YentenTros/LINEFOLLOWER/gebruiksaanwijzing/readme.md

### settings
De robot rijdt stabiel met volgende parameters:  
power:  76  
diff: 0.46  
kp: 17.70
