YentenTros/LINEFOLLOWER/bill of materials/BOM.pdf

nr | Naam | omschrijving | Prijs/Stuk Aantal | Subtotaal
1 Microcontroller | ATmega328 (Arduino Nano) | 23 | 1 | 23
2 Sensoren | QTR-8A/8x-ir-lijn-tracking-module | 4,5 | 1 | 4,5
3 H-bruggen | TB6612FNG Motordriver | 7 | 1 | 7
4 Bluetooth module HC-05 | 10,5 | 1 | 10,5
5 Motoren | JGA12-N20-50 | 4,5 | 2 | 9
6 Led | Led Groen 5V | 0 | 1 | 0
7 Drukknop | Drukknop | 0 | 1 | 0
8 Schakelaar | Mini wipschakelaar | 0,5 | 1 | 0,5
9 Weerstand | Weerstand 220Ω | 0 | 1 | 0
10 Batterij | lithium ions | 5,75 | 2 | 11,5
11 Batterij houder | 2 | 1 | 2
12 Wiel | DC Gearbox wiel 65mm | 2,2 | 2 | 4,4
13 printplaatje | dubbelzijdige 4cm*6cm printplaat | 0,7 | 1 | 0,7
73,1

Model A
