YentenTros/LINEFOLLOWER/technische tekeningen/elektronisch/Aansluitschema+poc's.pdf

9000

F26_001

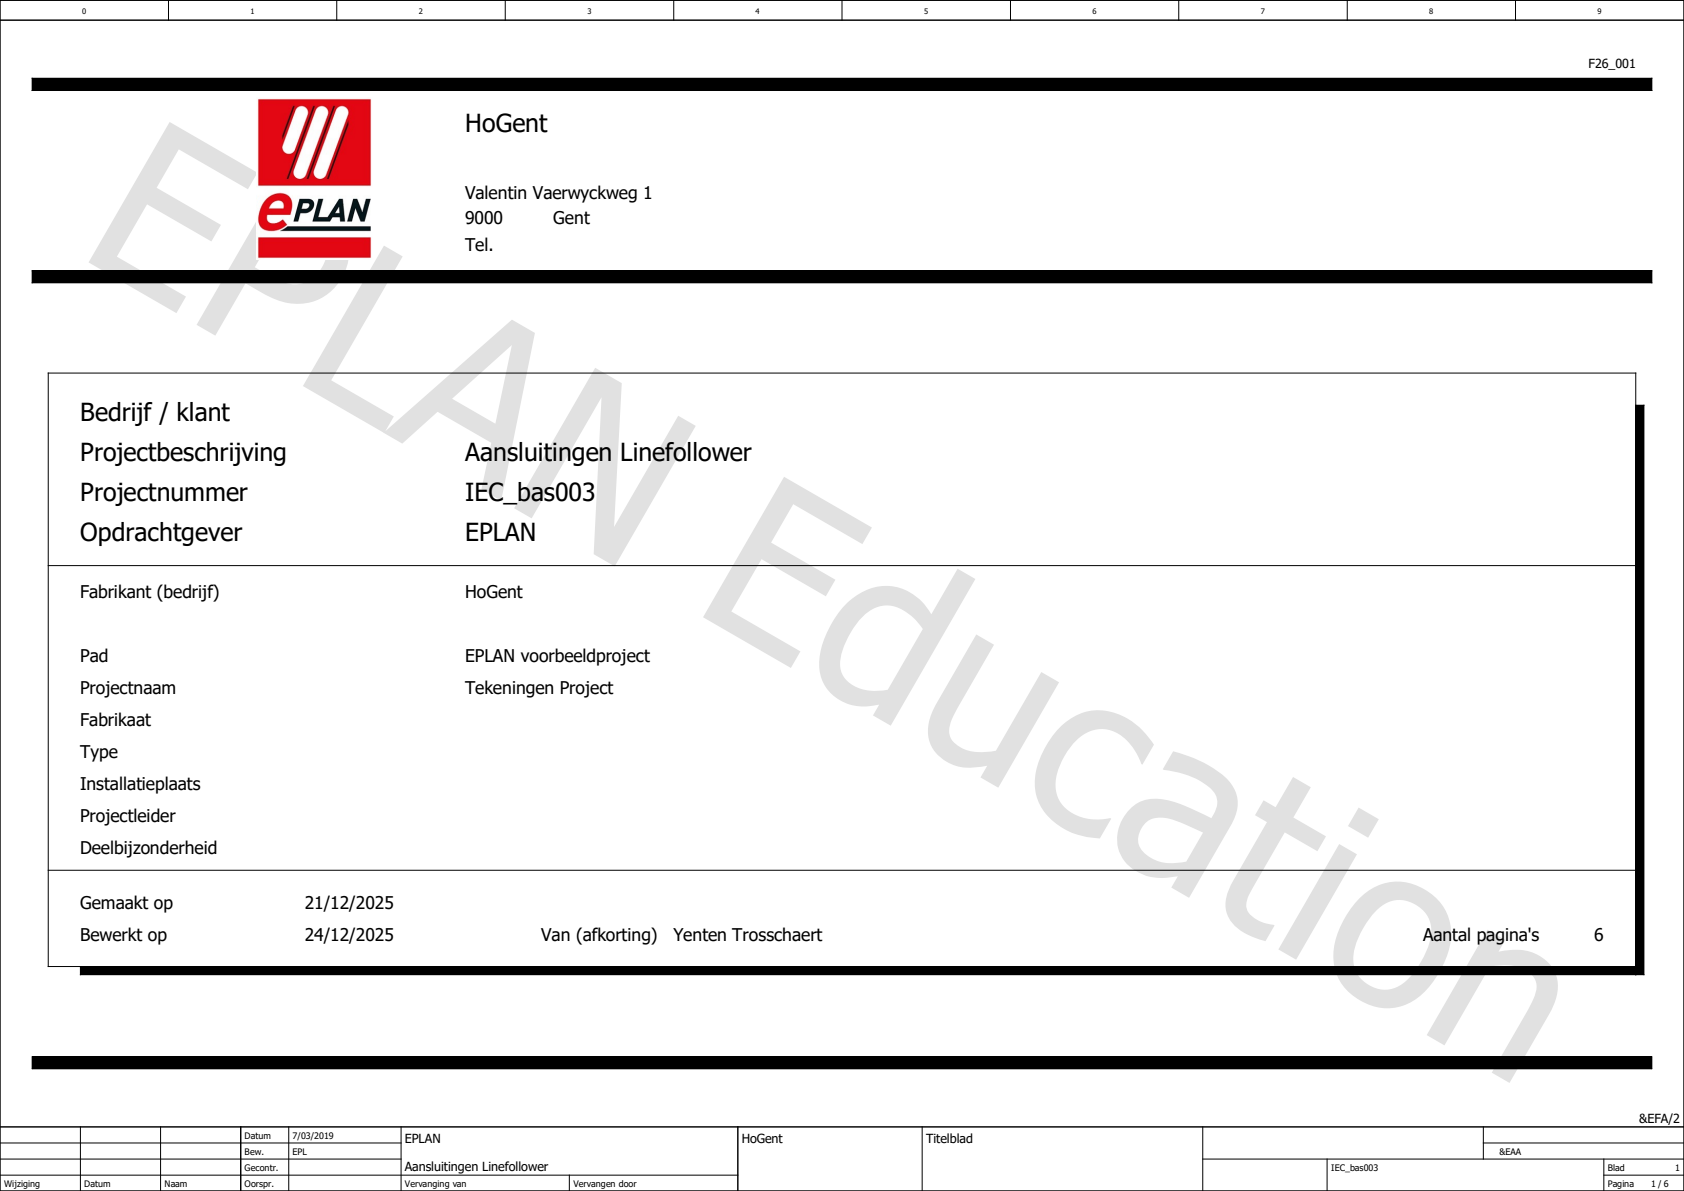
[picture p7: page 1]
&EFA/2; HoGent; Projectbeschrijving; Aansluitingen Linefollower; Aantal pagina's; Opdrachtgever; Bewerkt op; IEC_bas003; Gemaakt op; Projectnummer; EPLAN voorbeeldproject; Fabrikaat; Yenten Trosschaert; Deelbijzonderheid; Valentin Vaerwyckweg 1; Pad; Fabrikant (bedrijf); Projectnaam; Tekeningen Project; Projectleider; Tel.; Type; Bedrijf / klant; Installatieplaats; Van (afkorting); EPLAN; Gent

7/03/2019 | EPLAN Aansluitingen Linefollower | HoGent | Titelblad

Bew. | EPL | | | | &EAA
Gecontr. | | | | | IEC_bas003 | Blad

Wijziging | Datum | Naam | Oorspr. | | Vervanging van | Vervangen door | | | | Pagina 1 / 6

HC-05

## 2 Li-ion Batterijen

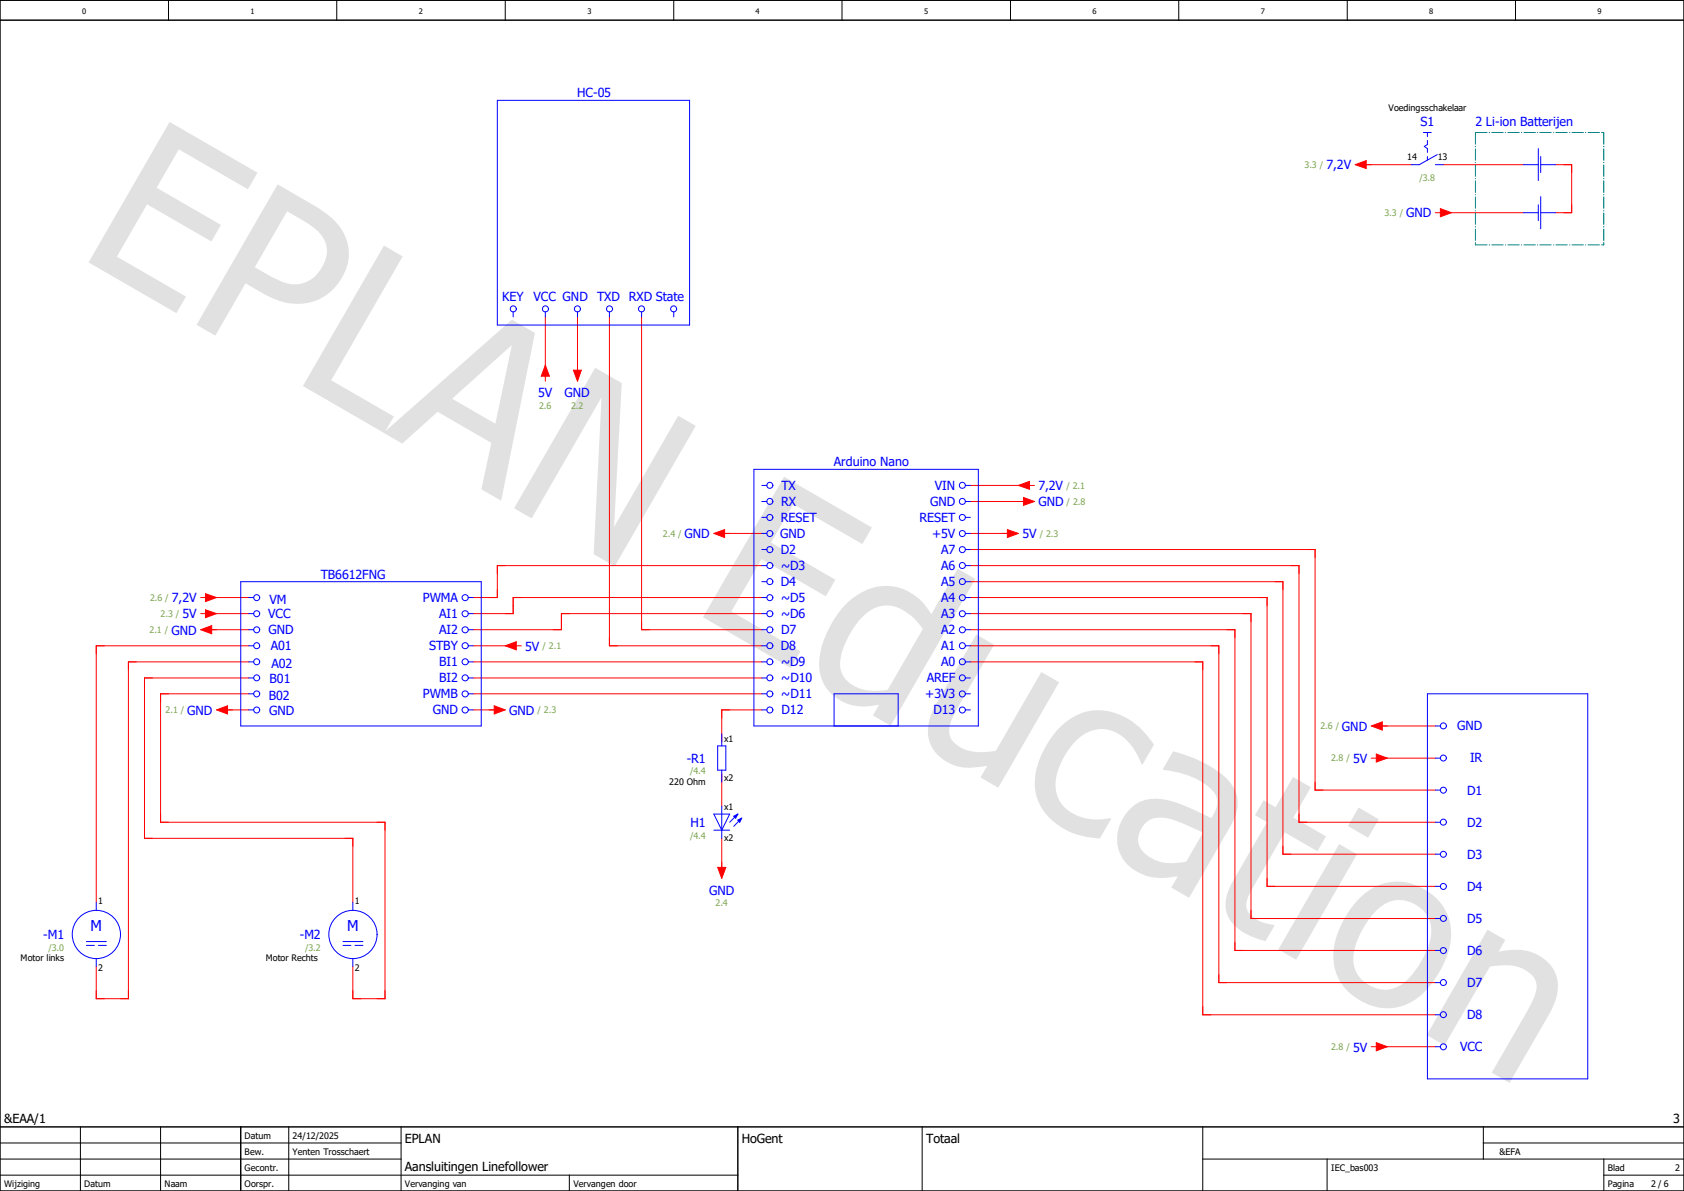
[picture p8: page 2]

KEY VCC GND TXD RXD State

24/12/2025 | HoGent | Totaal
Yenten Trosschaert | | | &EFA

## 2 Li-ion Batterijen

S1

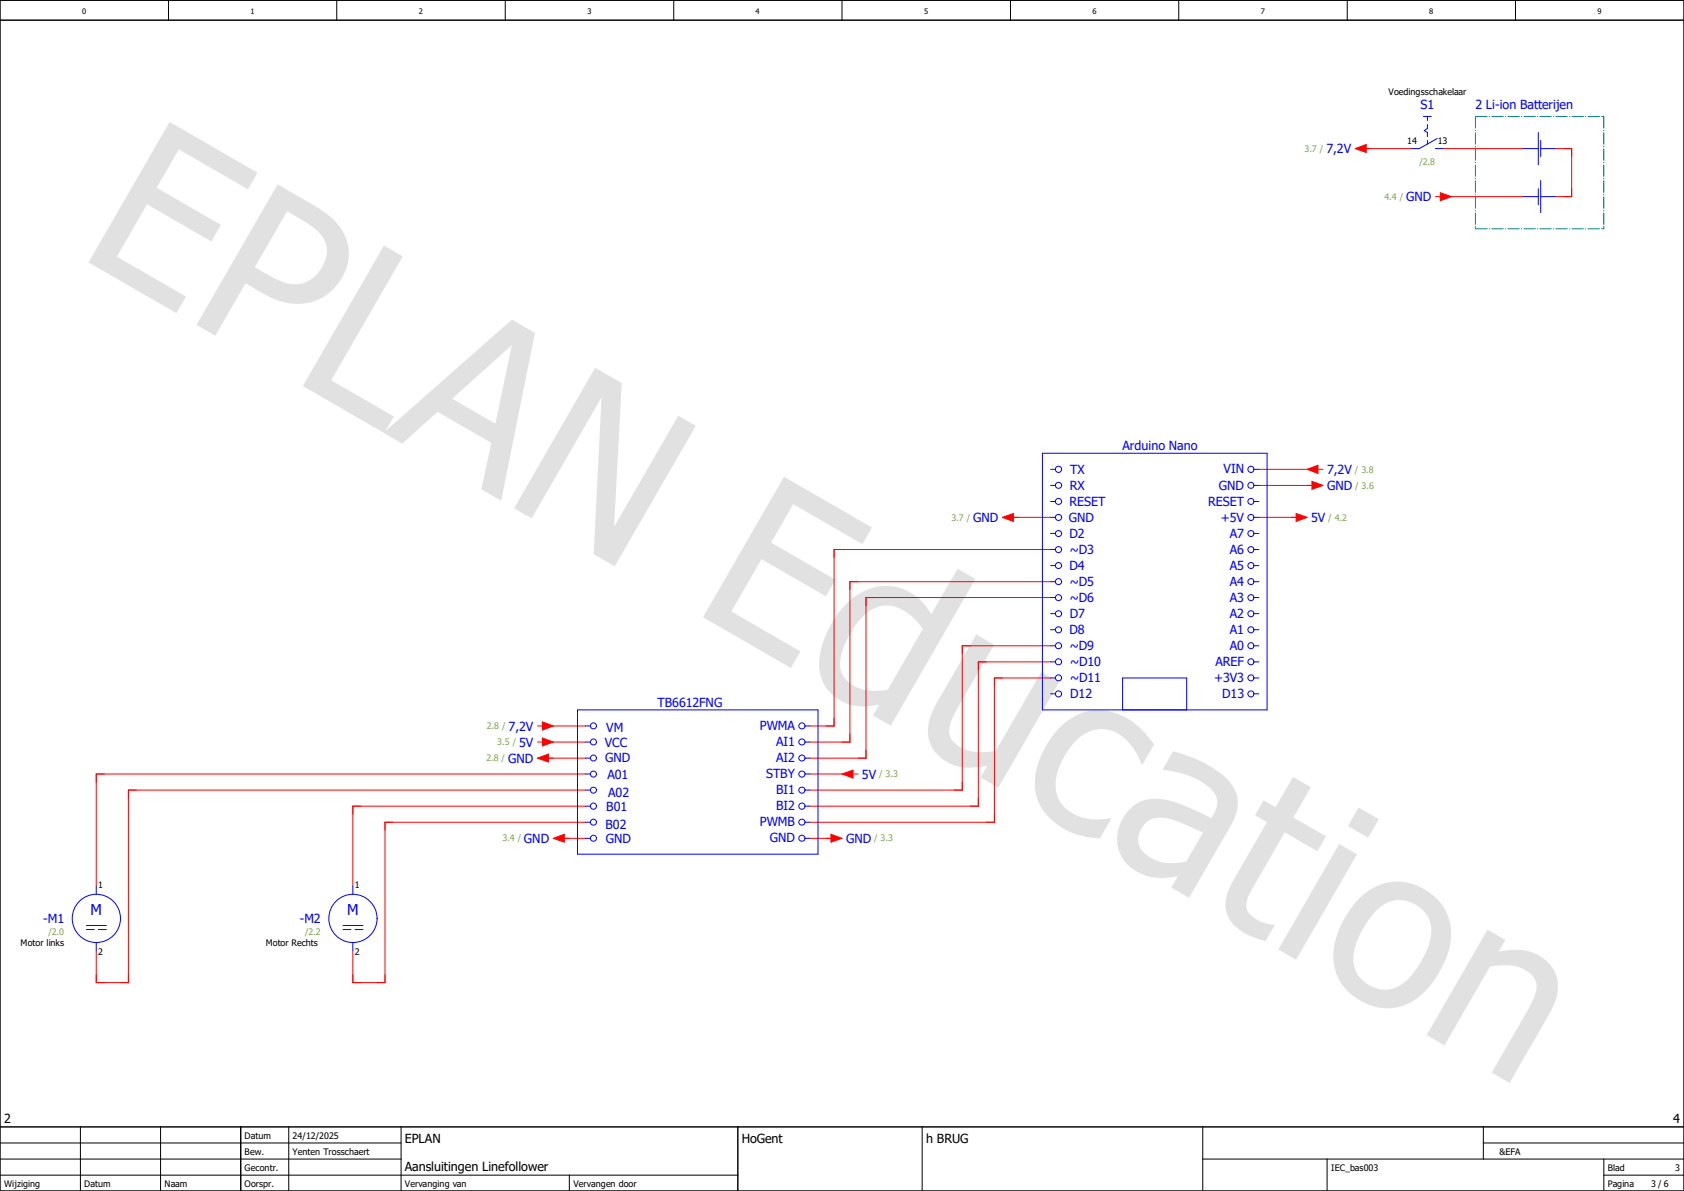
[picture p9: page 3]
h BRUG; Arduino Nano; TB6612FNG; TX RX RESET; AREF; RESET; VIN; GND; Voedingsschakelaar; PWMB; STBY; PWMA; VCC GND A01 A02 B01 B02 GND; Motor links; Motor Rechts; 4.4 / GND; GND / 3.6; 3.7 / GND; 3.4 / GND; 2.8 / GND; GND / 3.3

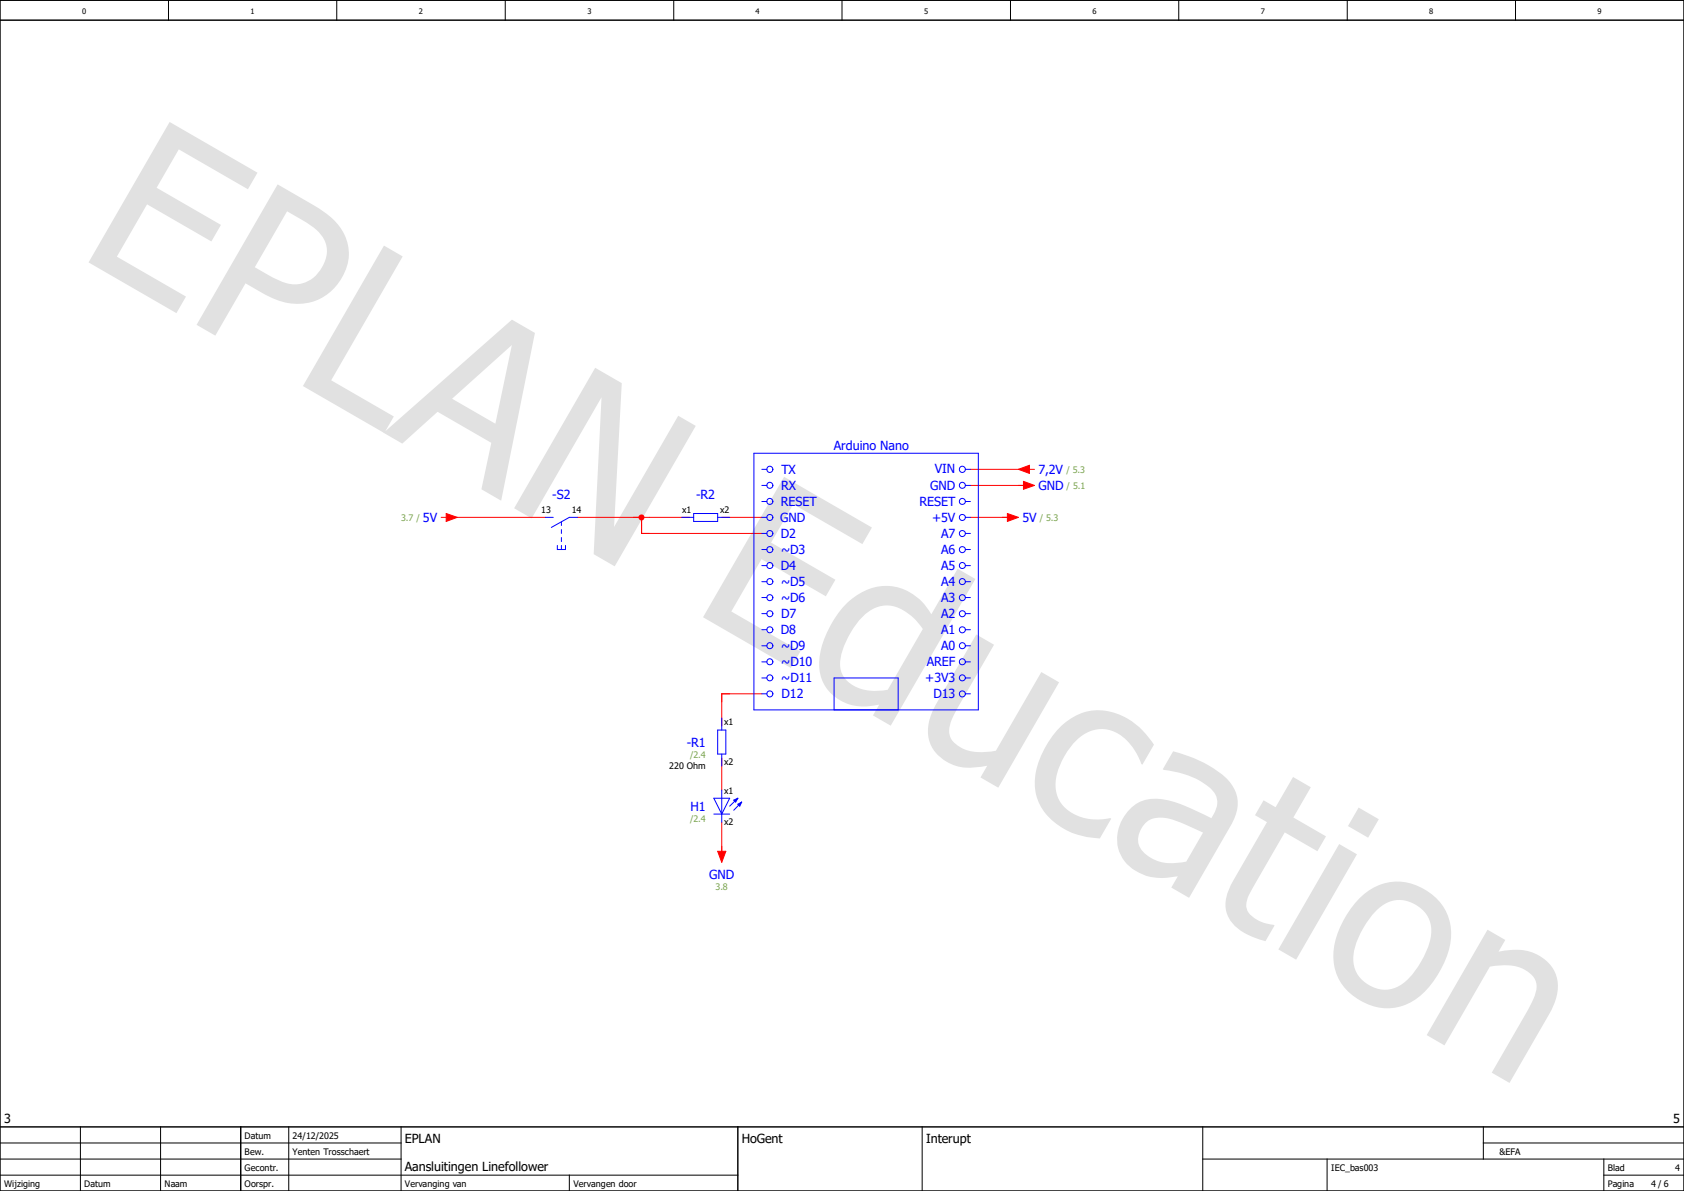
[picture p10: page 4]
Interupt; Arduino Nano; TX RX RESET; AREF; RESET; VIN; GND; -R1 /2.4 220 Ohm; GND / 5.1; GND 3.8

## Arduino Nano

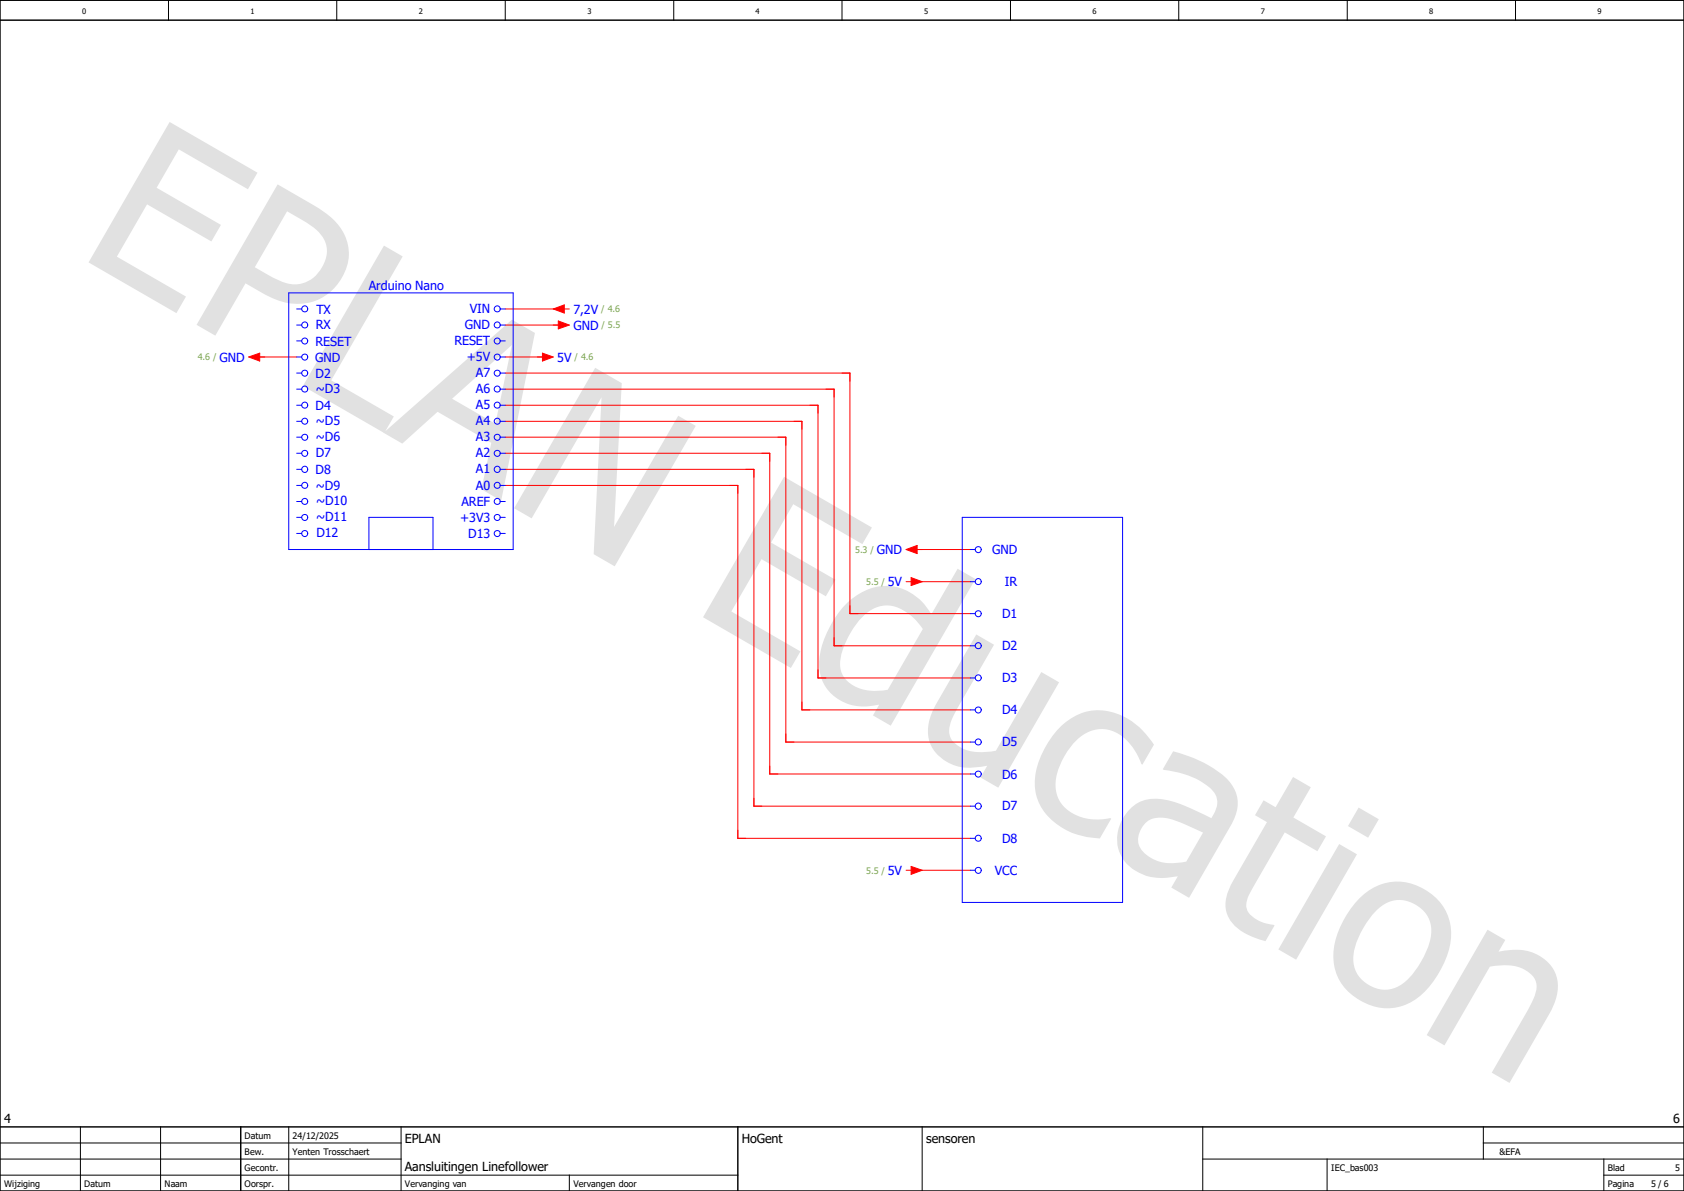
[picture p11: page 5]

HC-05

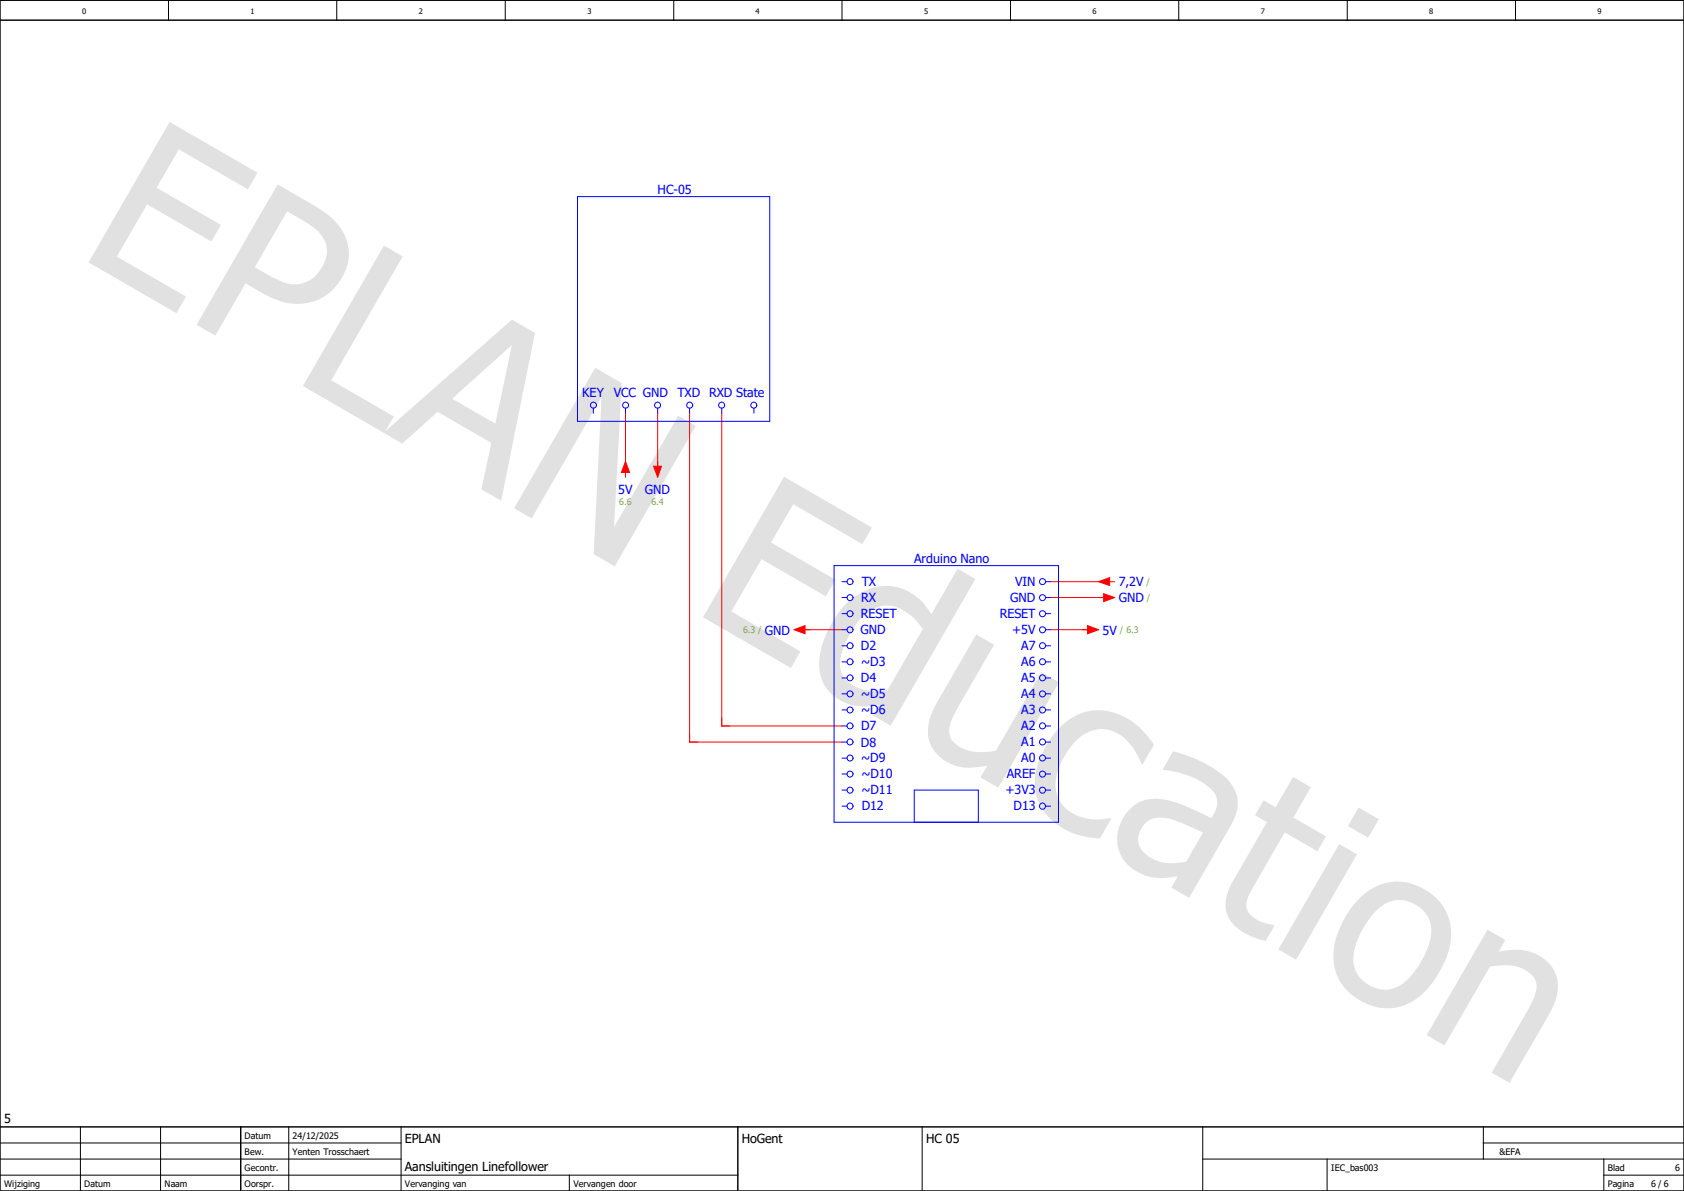
[picture p12: page 6]
Arduino Nano; TX RX RESET; AREF; RESET; VIN; GND; GND /; 6.3 / GND; GND 6.4

KEY VCC GND TXD RXD State
